gbrobotic/PulseLab/hardware/README.md

Coming in a later phase — see docs/ROADMAP.md.
