gbrobotic/PulseLab/docs/images/phase6_screens.png

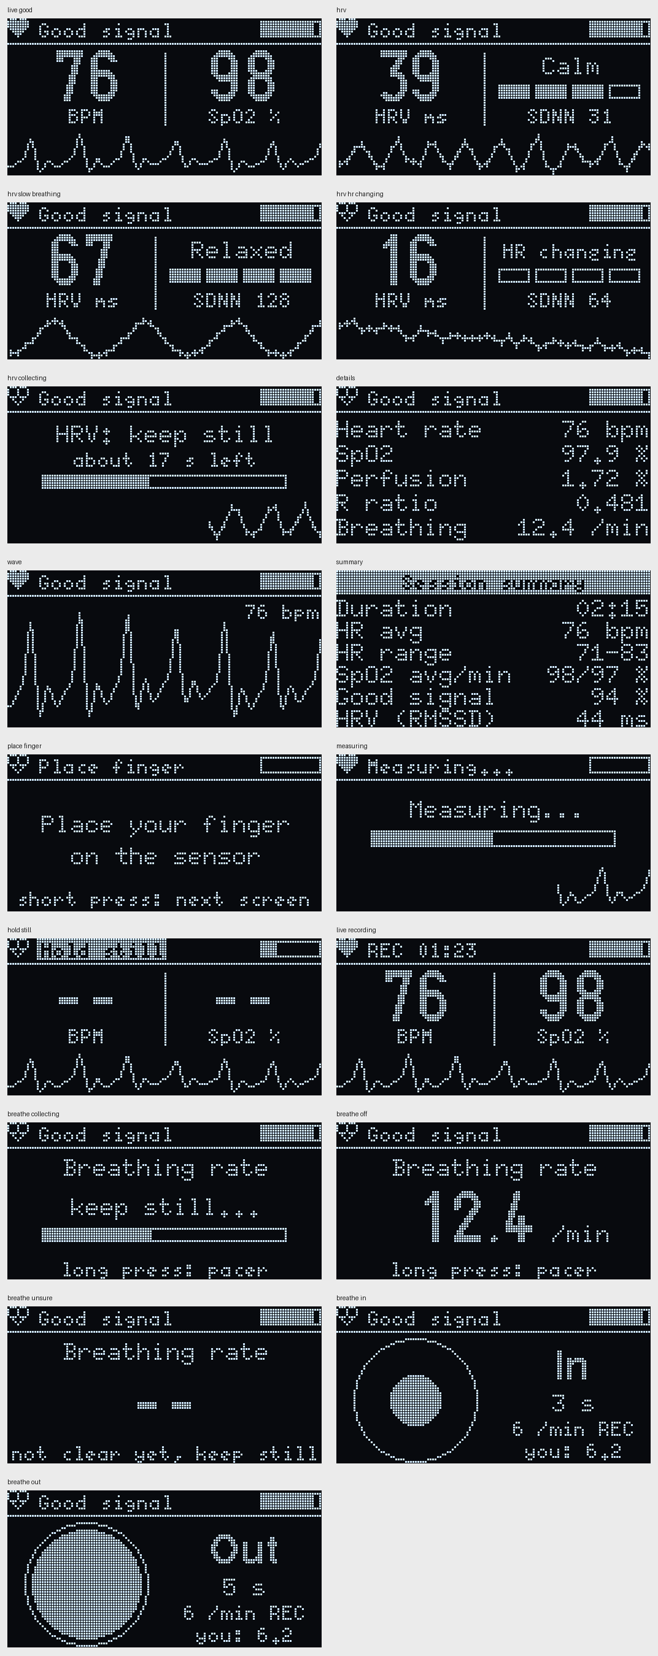
docs/images/phase6_screens.png
