gbrobotic/PulseLab/docs/images/phase6_sim_plot.png

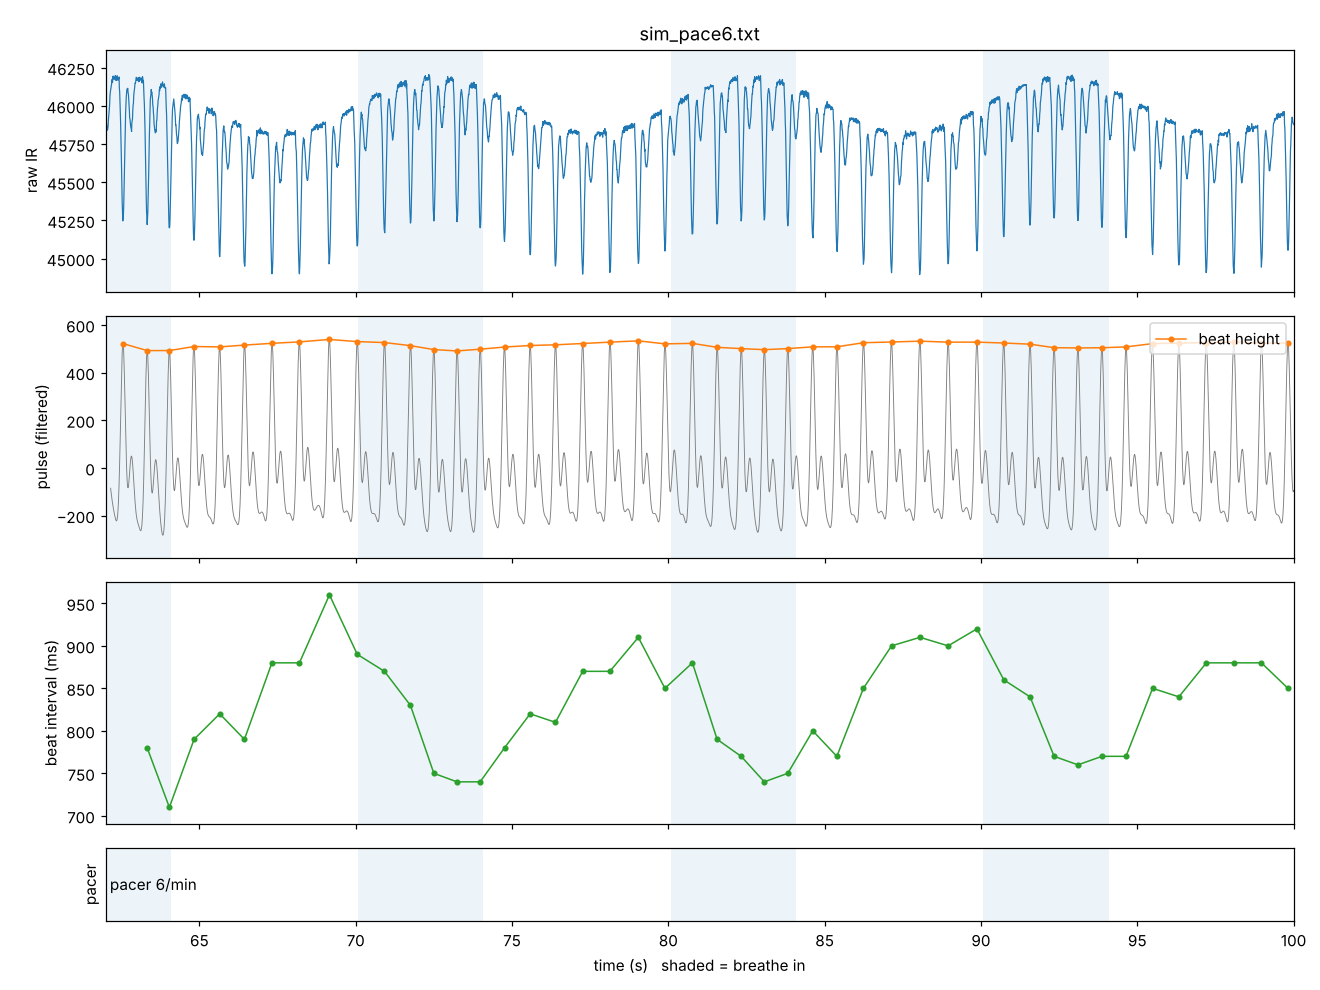
docs/images/phase6_sim_plot.png
