gbrobotic/PulseLab/docs/images/phase7_screens.png

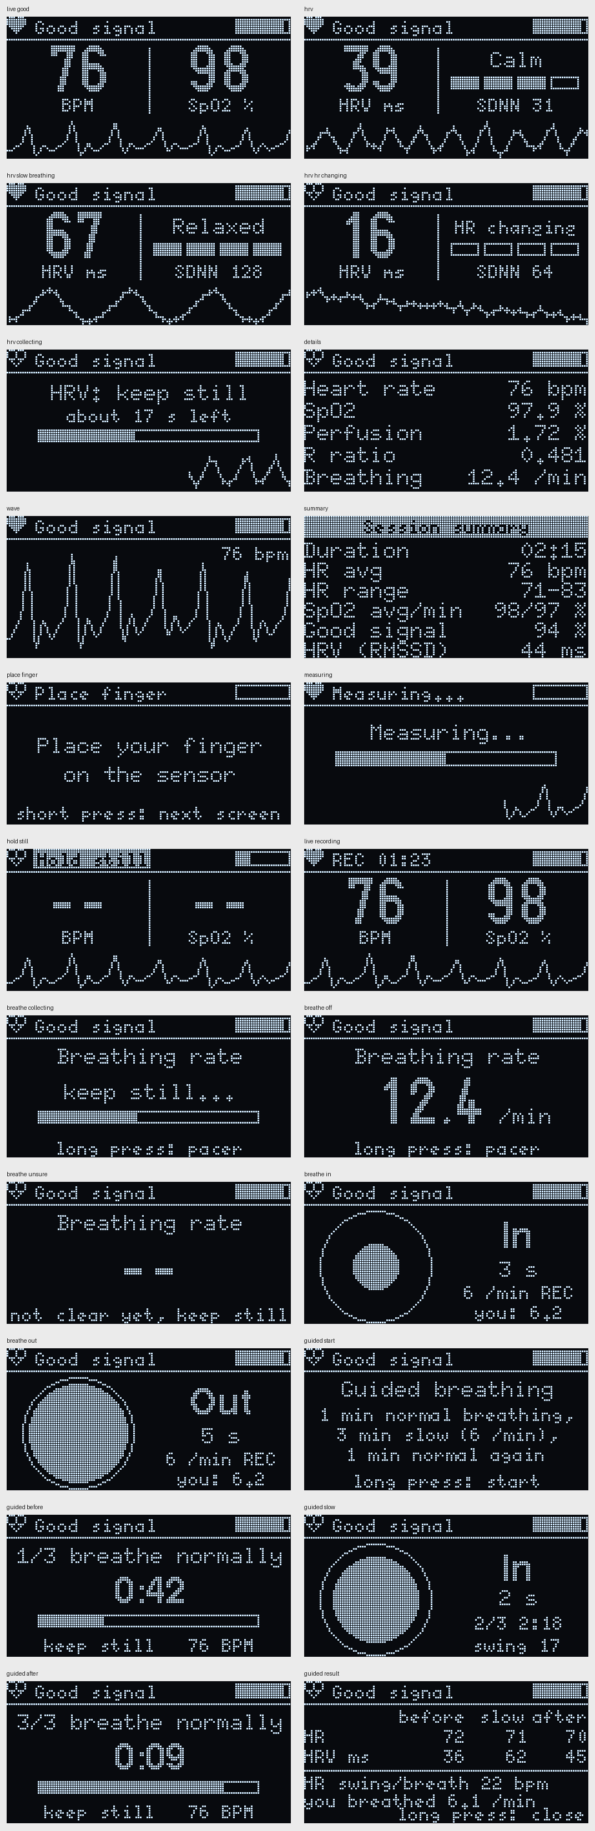
docs/images/phase7_screens.png
