gbrobotic/PulseLab/docs/images/phase10_case_open.png

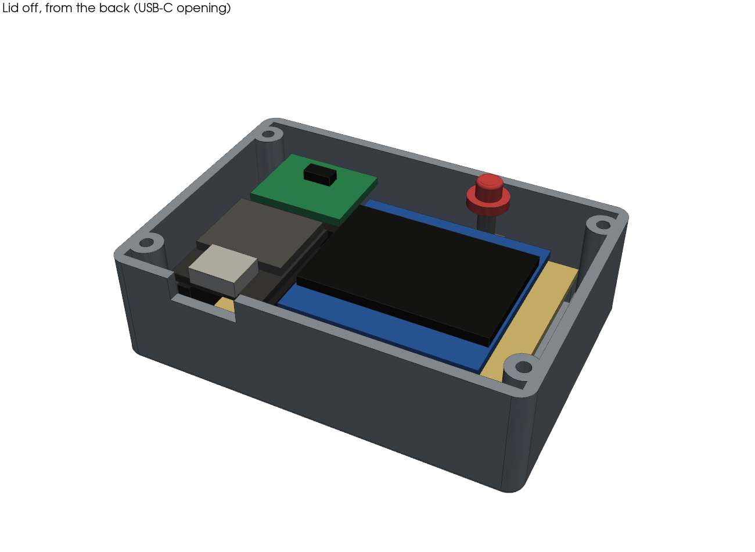
docs/images/phase10_case_open.png
