gbrobotic/PulseLab/enclosure/case_base.step

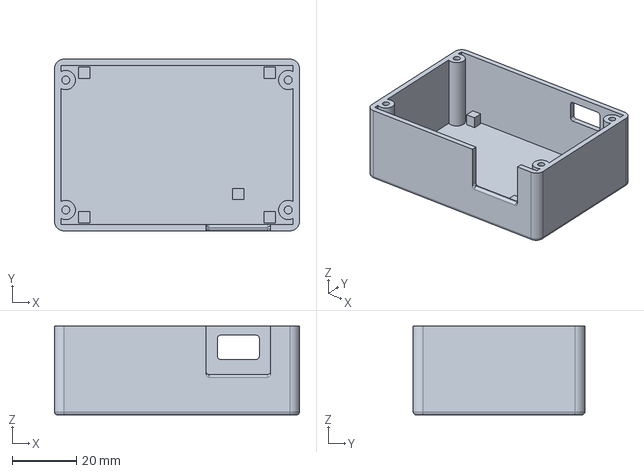
[picture p23: CAD file, 2026-10-22]
enclosure/case_base.step
76.0 x 53.3 x 27.6 mm
