gbrobotic/PulseLab/enclosure/case_lid.step

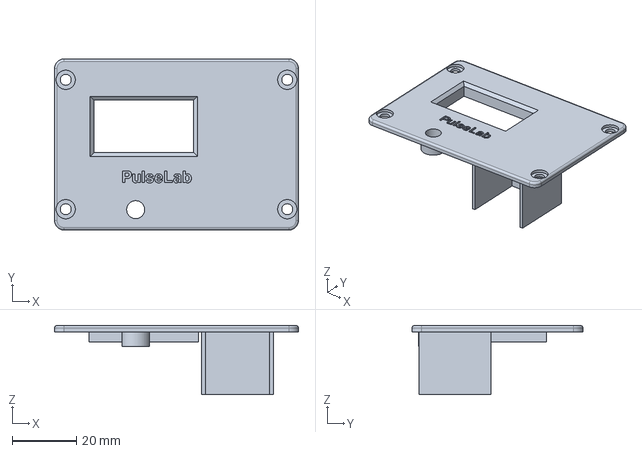
[picture p24: CAD file, 2026-10-22]
enclosure/case_lid.step
76.0 x 53.3 x 21.5 mm
