gbrobotic/PulseLab/enclosure/button_cap.step

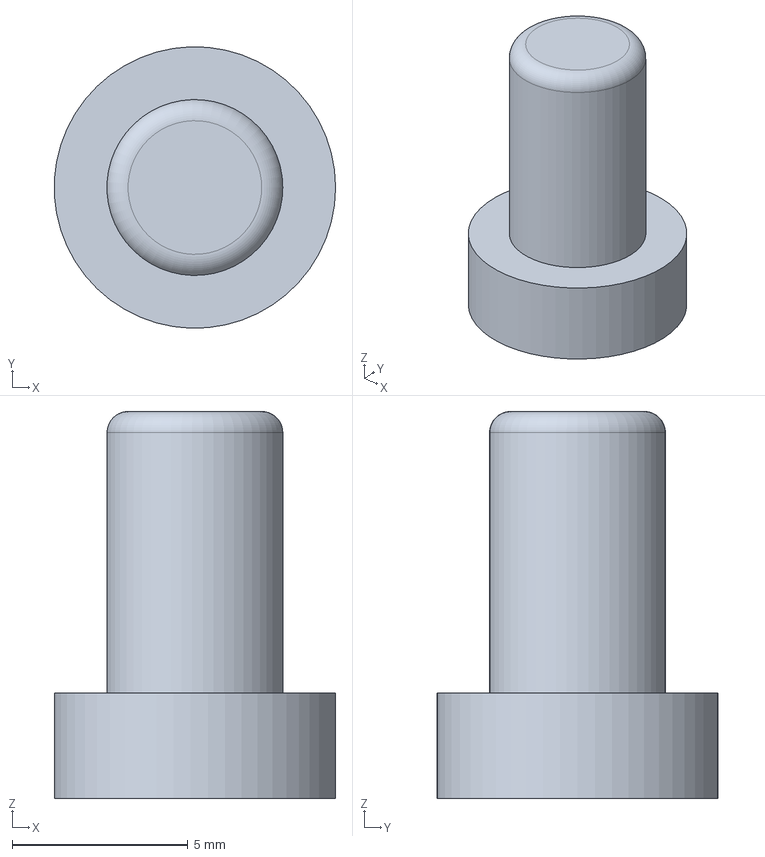
[picture p25: CAD file, 2026-10-22]
enclosure/button_cap.step
7.99 x 8.00 x 11.0 mm
