gbrobotic/PulseLab/enclosure/fit_test_plate.stl

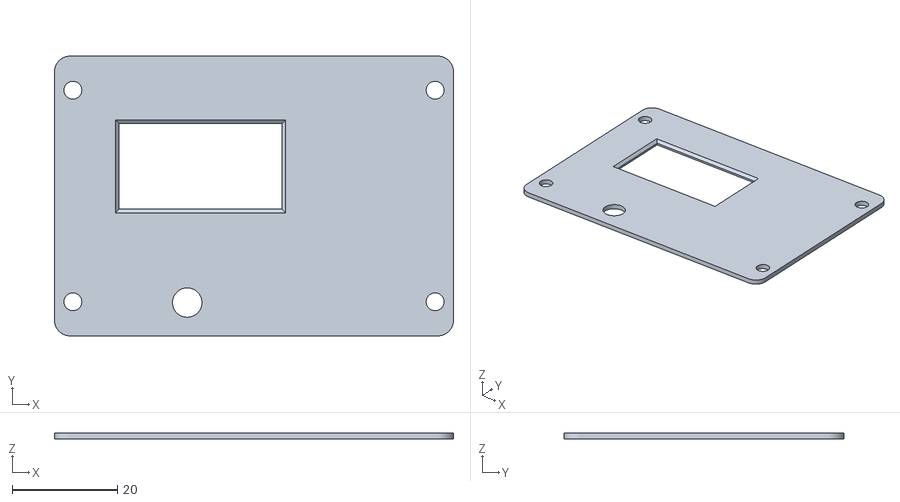
[picture p26: CAD file, 2026-10-22]
enclosure/fit_test_plate.stl
76.0 x 53.3 x 1.20
