gbrobotic/PulseLab/(list of files, cad)

Other CAD files:
enclosure/button_cap.stl
enclosure/case_base.stl
enclosure/case_lid.stl
