gbrobotic/PulseLab/validation/logs/raw_guided1.png

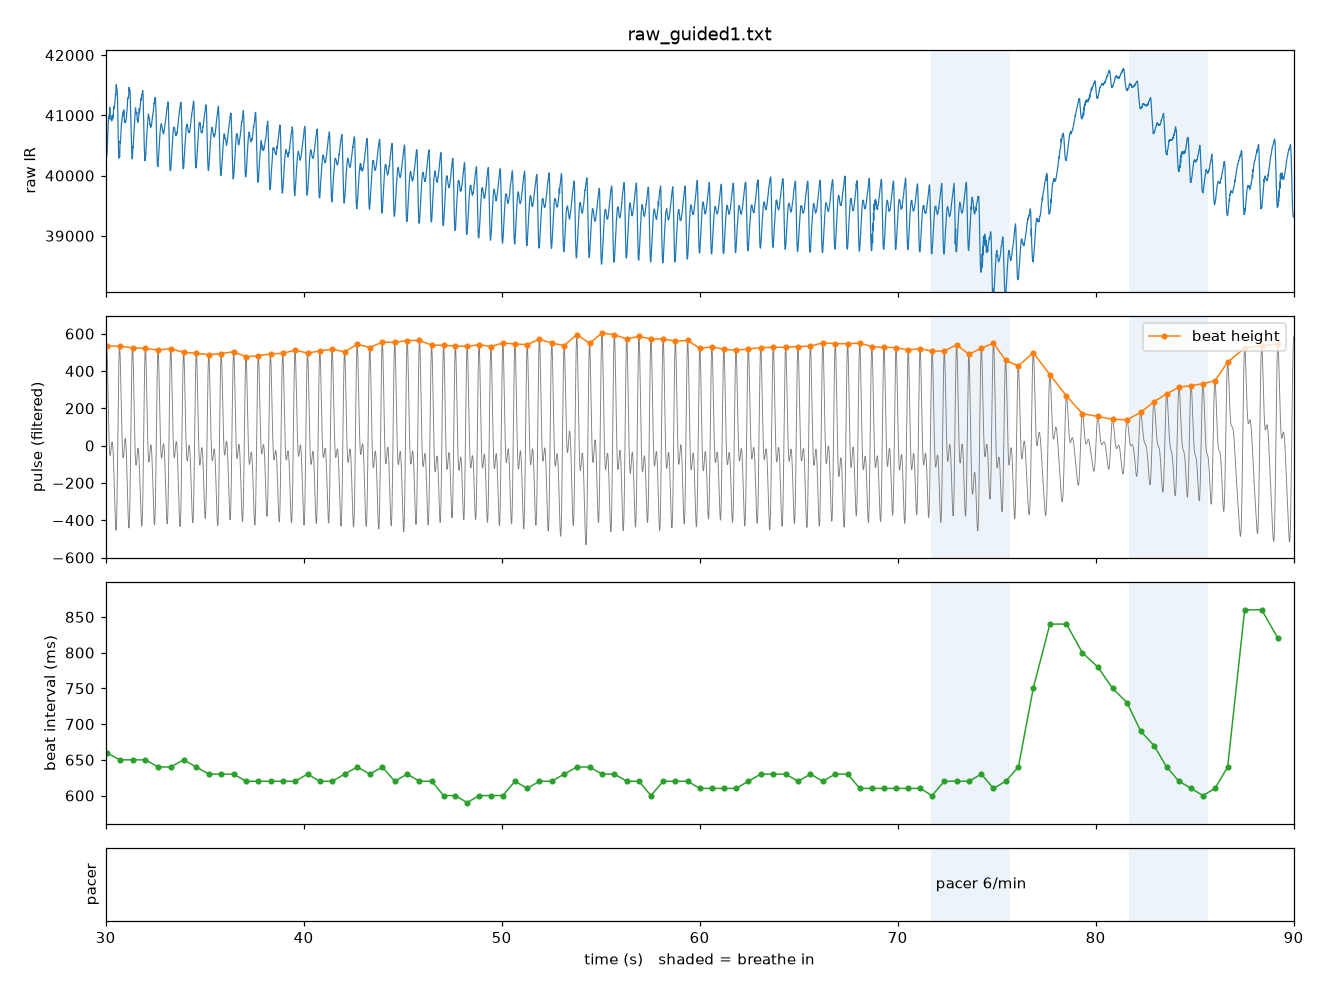
validation/logs/raw_guided1.png
