gbrobotic/PulseLab/validation/logs/dashboard_test1.csv

time | bpm | spo2 | pi | rmssd | breath | quality | stateText | showBpm | showSpo2 | hrvReady | breathValid | guidedPhase
2026-10-20T10:49:07.140Z | 0 | 0 | 0 | 0 | 0 | 0 | Place finger | false | false | false | false | 0
2026-10-20T10:49:07.623Z | 0 | 0 | 0 | 0 | 0 | 0 | Place finger | false | false | false | false | 0
2026-10-20T10:49:08.159Z | 0 | 0 | 0 | 0 | 0 | 0 | Place finger | false | false | false | false | 0
2026-10-20T10:49:08.648Z | 0 | 0 | 0 | 0 | 0 | 0 | Place finger | false | false | false | false | 0
2026-10-20T10:49:09.134Z | 0 | 0 | 0 | 0 | 0 | 0 | Place finger | false | false | false | false | 0
2026-10-20T10:49:09.623Z | 0 | 0 | 0 | 0 | 0 | 0 | Place finger | false | false | false | false | 0
2026-10-20T10:49:10.158Z | 0 | 0 | 0 | 0 | 0 | 0 | Place finger | false | false | false | false | 0
2026-10-20T10:49:10.646Z | 0 | 0 | 0 | 0 | 0 | 0 | Place finger | false | false | false | false | 0
2026-10-20T10:49:11.134Z | 0 | 0 | 0 | 0 | 0 | 0 | Place finger | false | false | false | false | 0
2026-10-20T10:49:11.622Z | 0 | 0 | 0 | 0 | 0 | 0 | Place finger | false | false | false | false | 0
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
