gbrobotic/PulseLab/validation/sim/simulated_readings.csv

# SIMULATED DATA - NOT REAL MEASUREMENTS. Made by make_sim_readings.py to test analyze.py.
reading_id | subject | condition | set | pulselab_hr | reference_hr | pulselab_spo2 | reference_spo2 | pulselab_r | notes
1 | S1 | rest | cal | 68.9 | 71 | 103.0 | 99 | 0.279 | simulated
2 | S1 | rest | cal | 64.0 | 64 | 102.7 | 99 | 0.292 | simulated
3 | S1 | rest | cal | 57.3 | 59 | 100.0 | 98 | 0.400 | simulated
4 | S1 | rest | cal | 68.4 | 69 | 104.4 | 100 | 0.224 | simulated
5 | S1 | after_exercise | cal | 93.2 | 95 | 99.9 | 97 | 0.406 | simulated
6 | S1 | after_exercise | cal | 93.3 | 94 | 103.8 | 99 | 0.249 | simulated
7 | S1 | after_exercise | cal | 85.9 | 89 | 104.1 | 99 | 0.237 | simulated
8 | S2 | rest | cal | 62.3 | 62 | 102.6 | 99 | 0.295 | simulated
9 | S2 | rest | cal | 66.9 | 67 | 99.4 | 97 | 0.423 | simulated
10 | S2 | rest | cal | 67.6 | 67 | 99.3 | 97 | 0.428 | simulated
11 | S2 | rest | cal | 66.0 | 67 | 102.4 | 99 | 0.305 | simulated
12 | S2 | after_exercise | cal | 95.2 | 98 | 99.2 | 96 | 0.432 | simulated
13 | S2 | after_exercise | cal | 89.6 | 90 | 101.1 | 98 | 0.357 | simulated
14 | S2 | after_exercise | cal | 90.1 | 90 | 98.7 | 97 | 0.453 | simulated
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
