gbrobotic/PulseLab/validation/logs/raw_free2.png

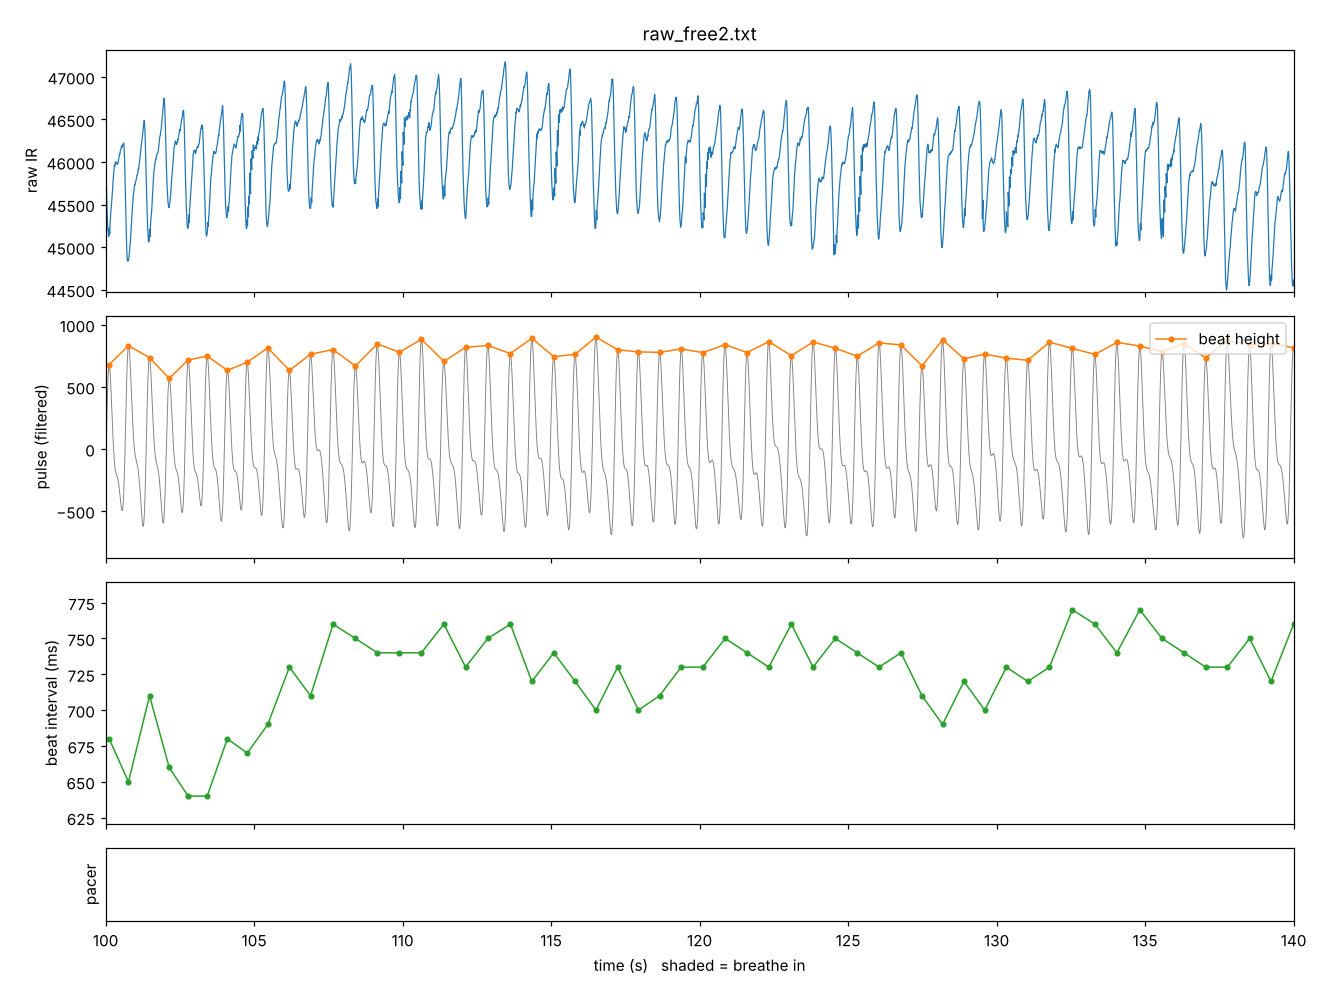
validation/logs/raw_free2.png
