gbrobotic/PulseLab/validation/logs/raw_free.png

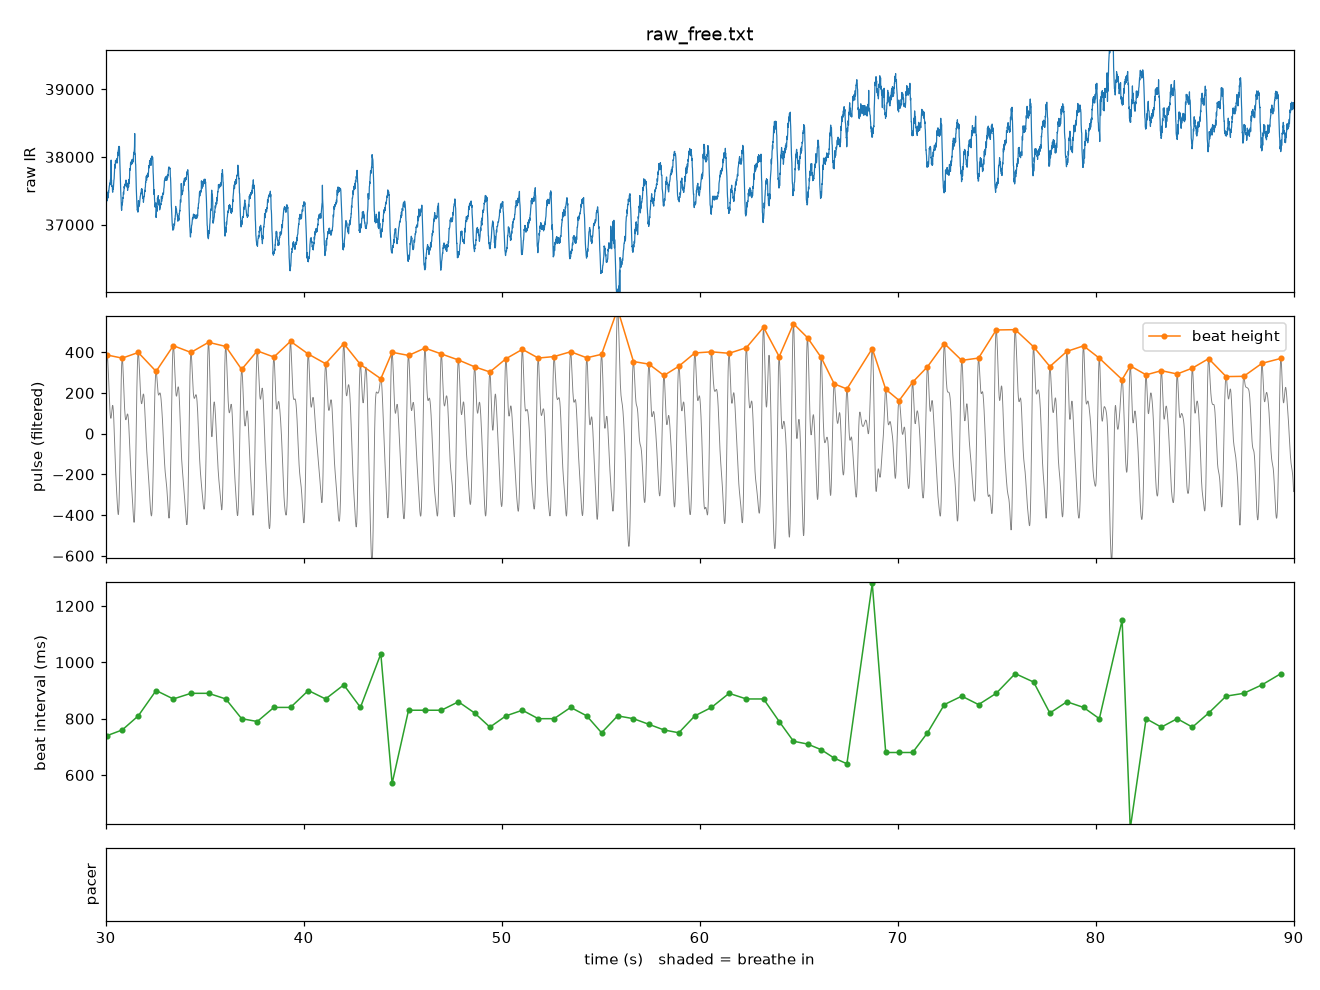
validation/logs/raw_free.png
