gbrobotic/PulseLab/validation/logs/raw_pace6.png

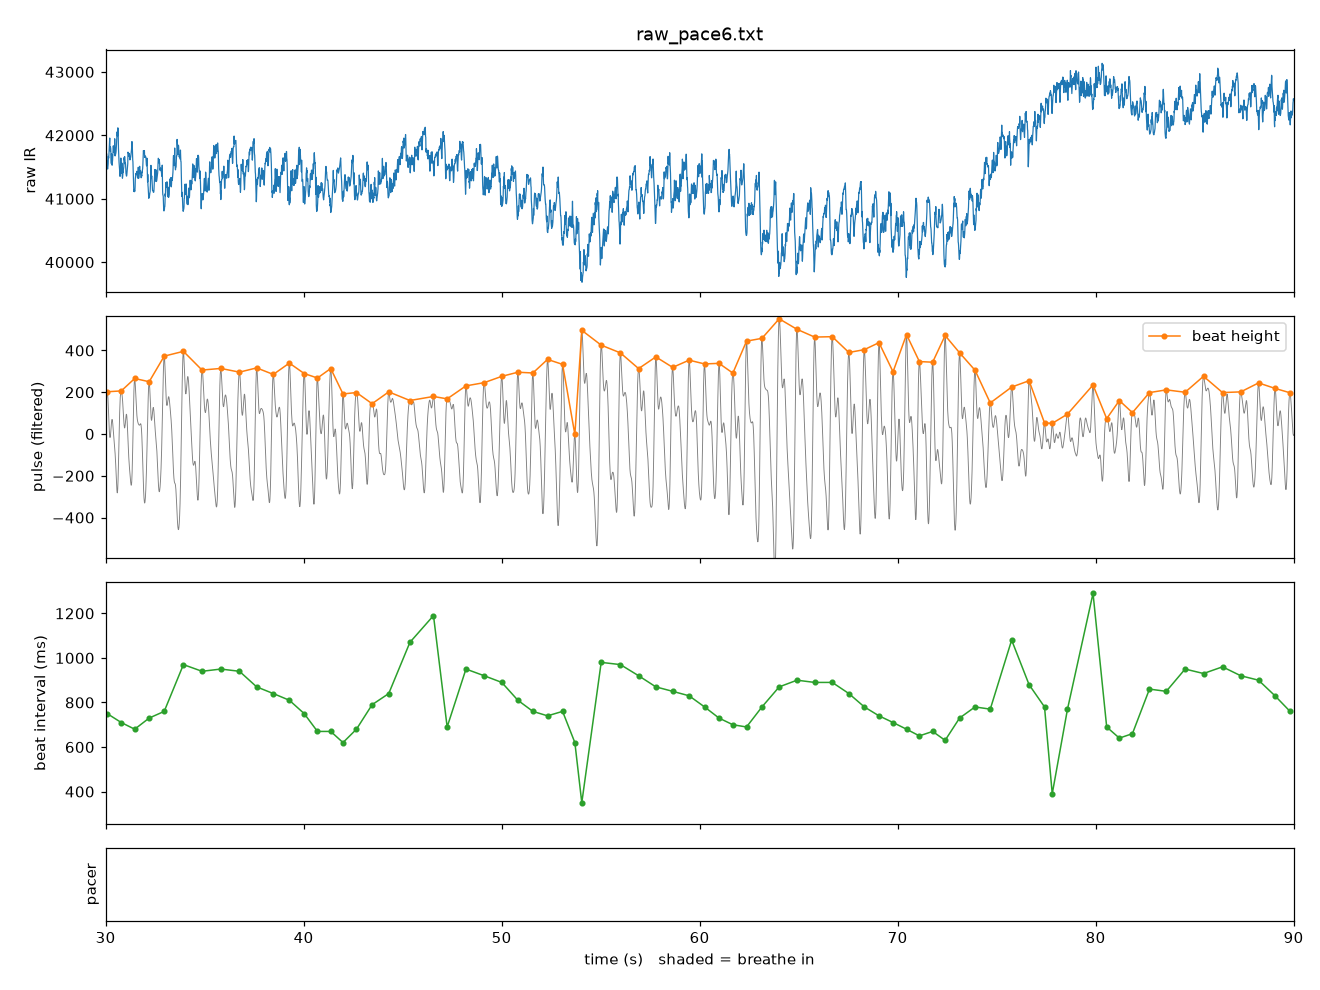
validation/logs/raw_pace6.png
