gbrobotic/PulseLab/validation/logs/raw_pace10.png

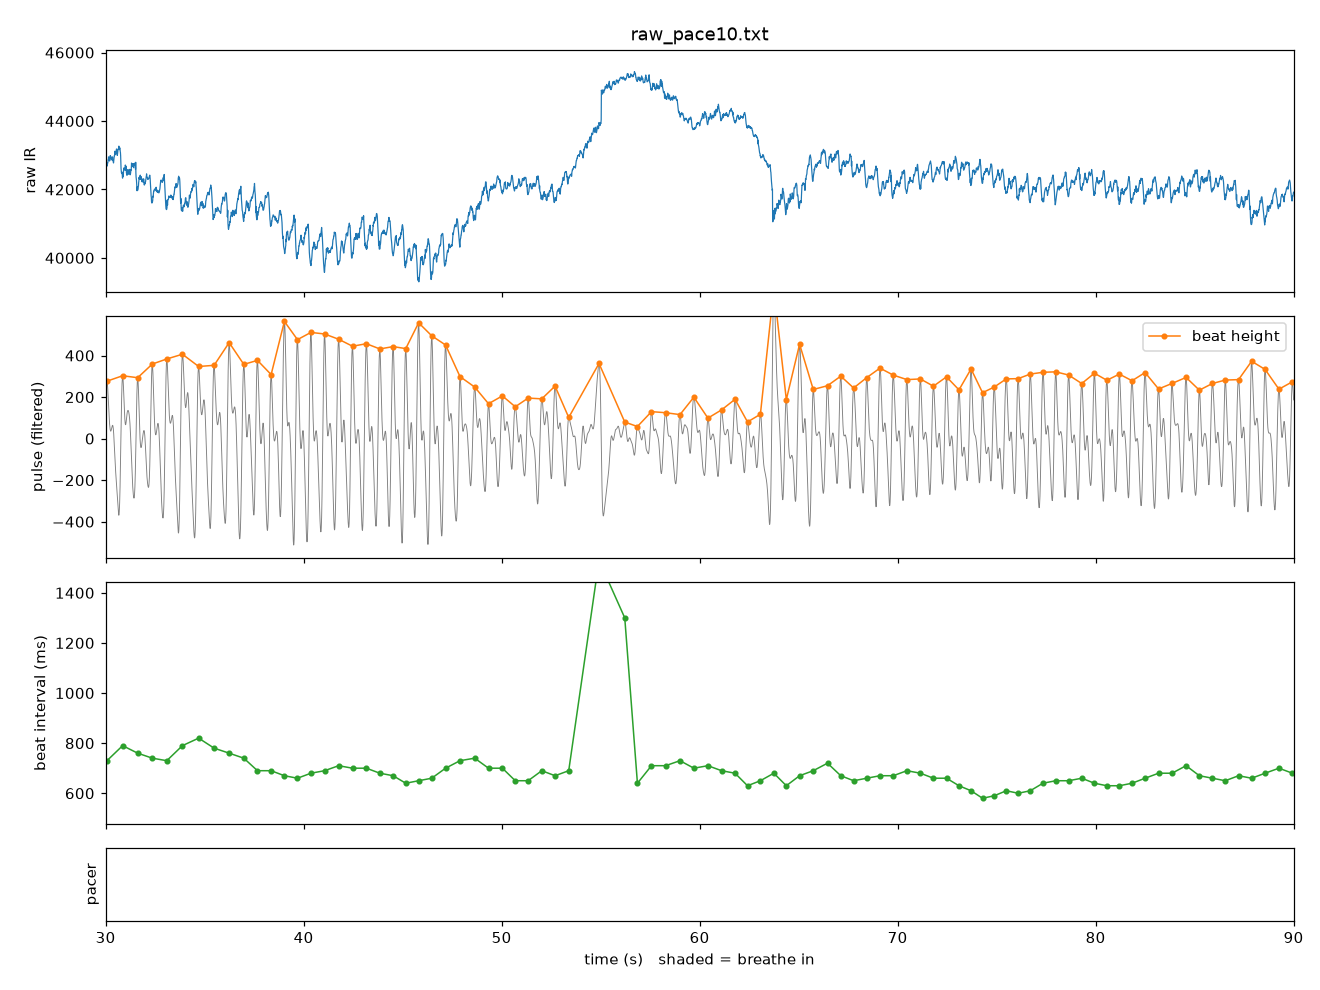
validation/logs/raw_pace10.png
