gbrobotic/PulseLab/validation/logs/raw_pace15.png

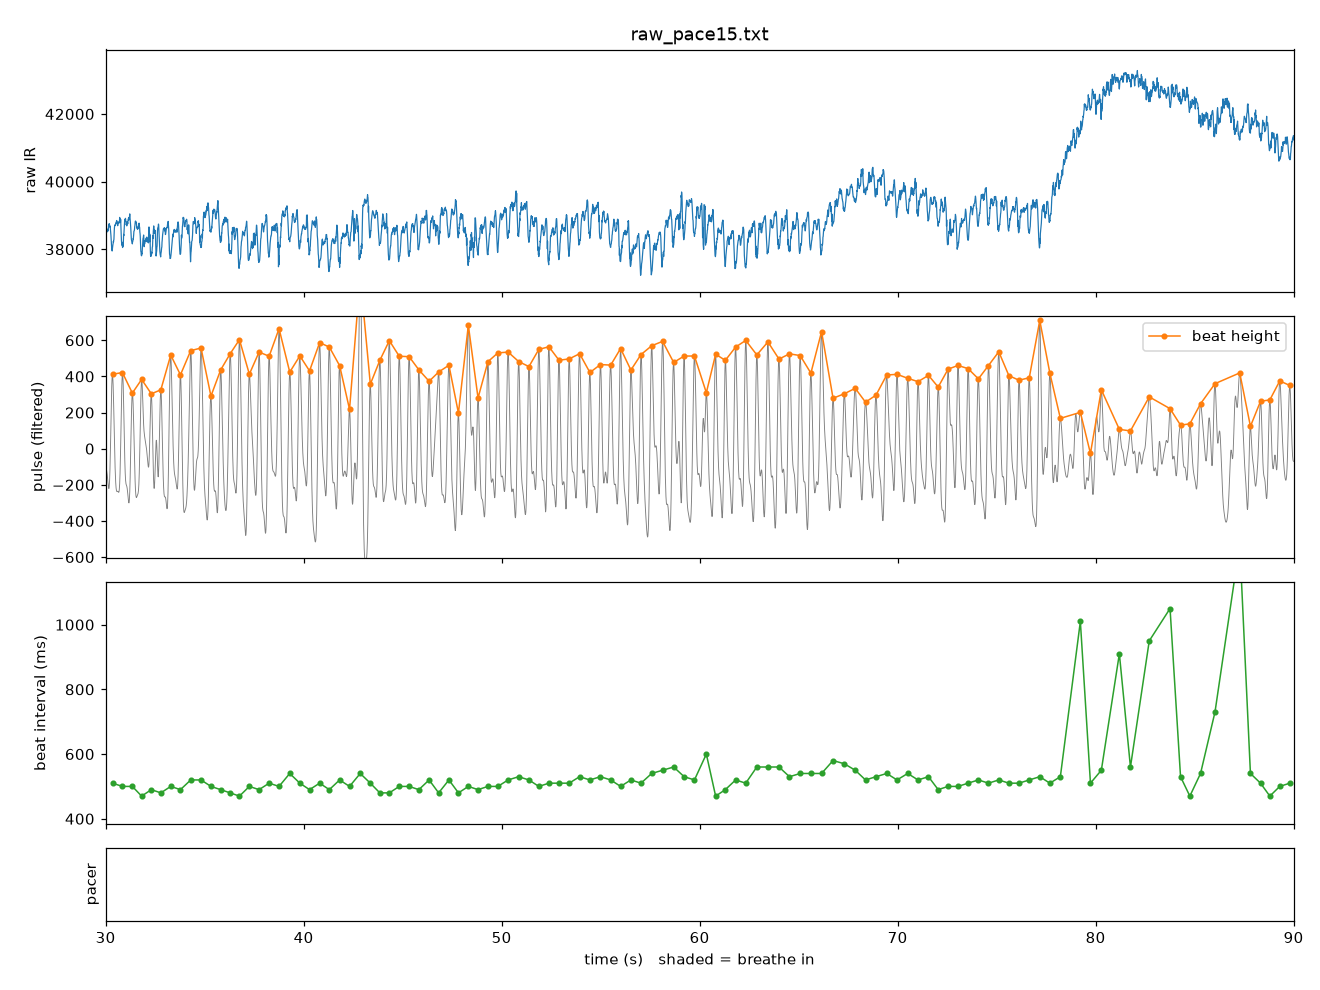
validation/logs/raw_pace15.png
