gbrobotic/PulseLab/validation/logs/raw_pace20.png

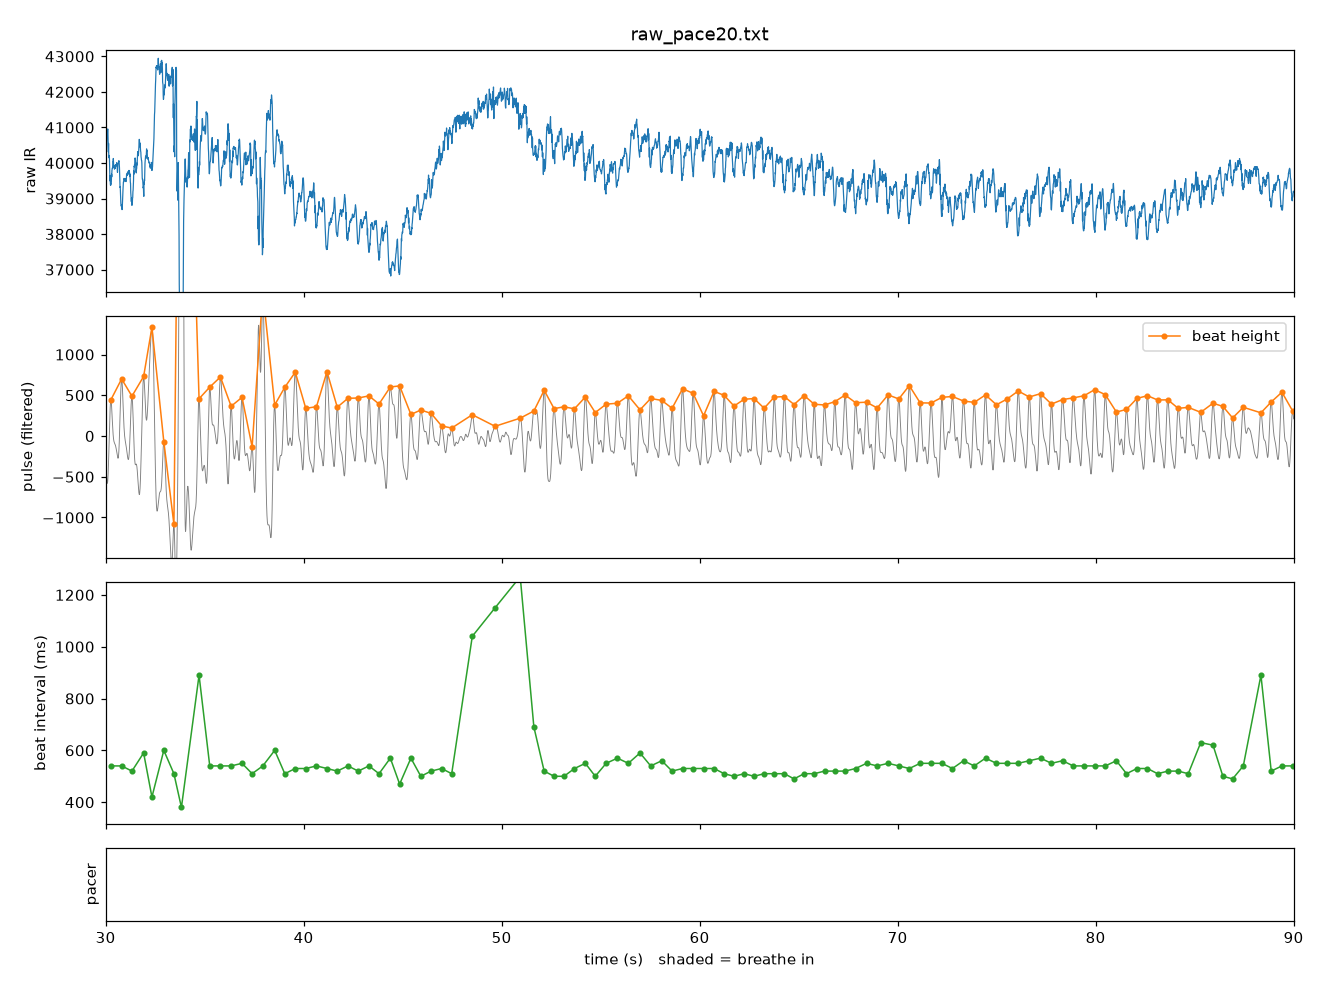
validation/logs/raw_pace20.png
