gbrobotic/PulseLab/validation/sim/bland_altman_hr.png

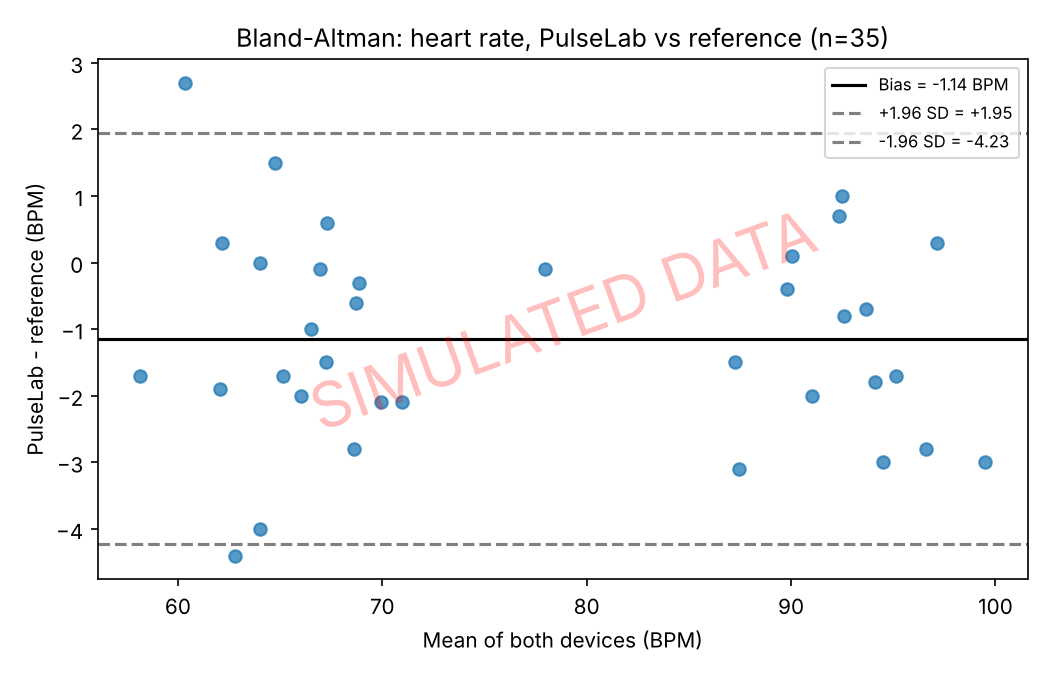
validation/sim/bland_altman_hr.png
