gbrobotic/PulseLab/validation/sim/bland_altman_spo2_cal.png

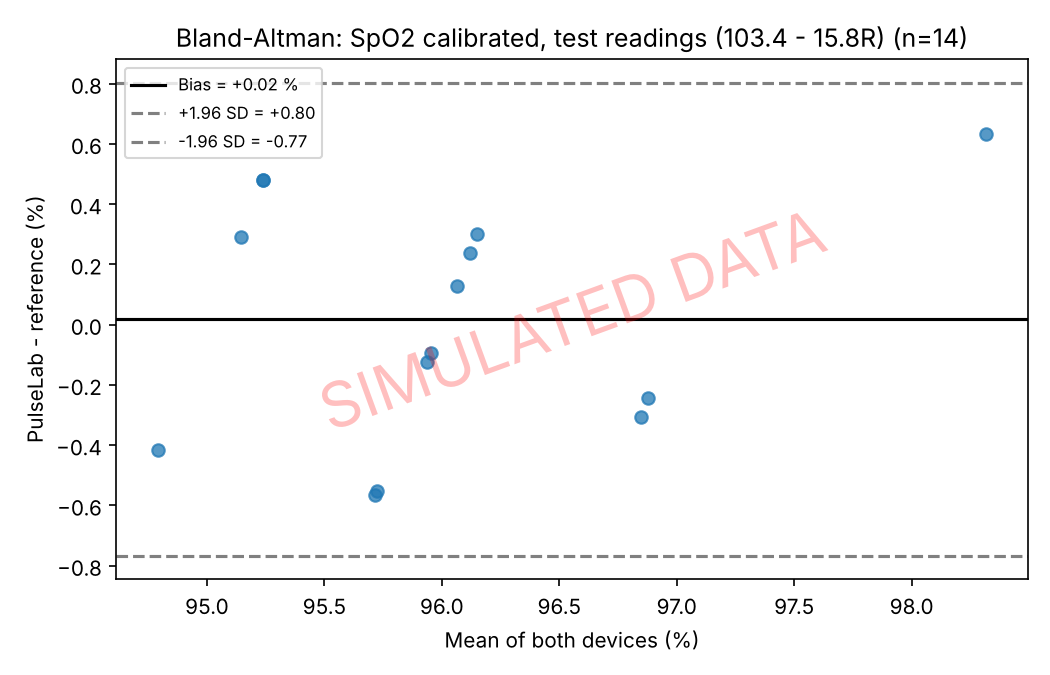
validation/sim/bland_altman_spo2_cal.png
