gbrobotic/PulseLab/validation/sim/bland_altman_spo2_uncal.png

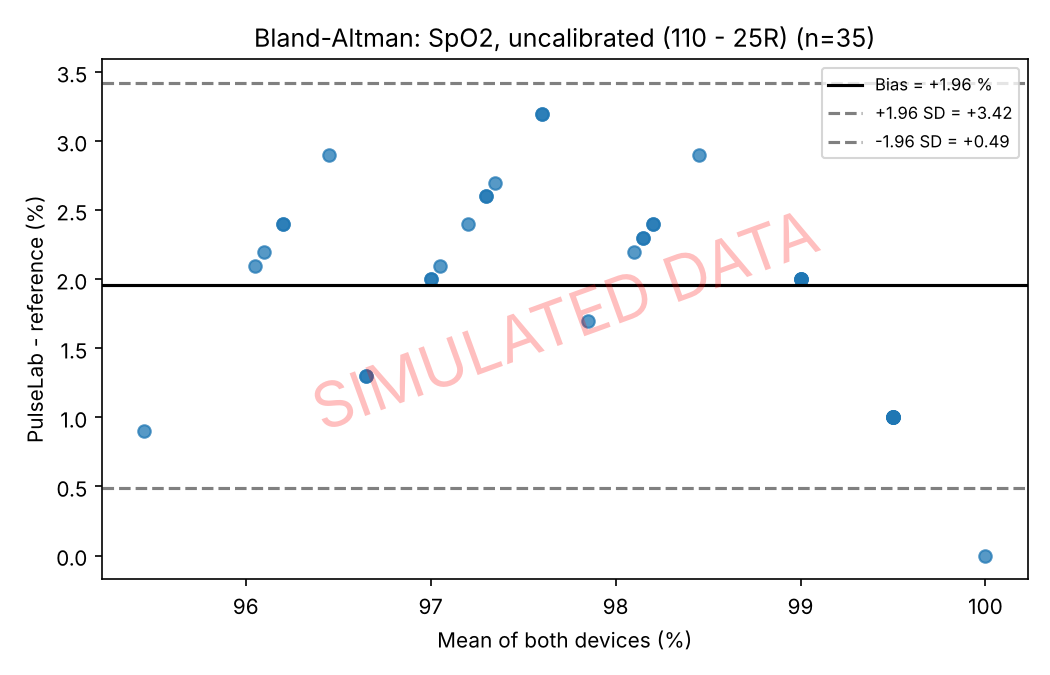
validation/sim/bland_altman_spo2_uncal.png
