gbrobotic/PulseLab/firmware/08_ble/08_ble.ino

/*
 * PulseLab - Phase 8: Bluetooth (BLE) + web dashboard
 *
 * Builds on Phase 7 and adds:
 *   ble_link.h     Bluetooth Low Energy: the standard Heart Rate service (any
 *                  fitness app can show the BPM) and a PulseLab service with
 *                  vitals, pulse wave, guided session and a control channel
 *   ble_packets.h  the byte layout of everything that's sent (tested on the PC)
 *   The web page in dashboard/ connects to it from Chrome (Web Bluetooth).
 *
 * From Phase 7:
 *   guided.h       a 5 minute guided session on the new "Guided" screen:
 *                  1 min normal breathing, 3 min slow breathing with the circle
 *                  (6 per minute), 1 min normal. At the end: heart rate and HRV
 *                  before / during / after, how much the heart rate swung with
 *                  each slow breath, and the breathing rate measured from you
 *
 * From Phase 6:
 *   breathing.h    breathing rate from the pulse: beat timing, pulse height and
 *                  baseline over the last 60 s, shown only when they agree
 *   SERIAL_MODE 3  raw recording: every sensor sample (100 per second) is sent
 *                  over Serial, so the breathing rate code can be developed and
 *                  tested on my real signal on the PC (validation/capture_serial.py)
 *   pacer.h        breathing pacer on a new "Breathe" screen. Breathing along
 *                  with it while recording means the true breathing rate is known
 *
 * Button (GPIO4 to GND):
 *   short press  next screen (Live -> HRV -> Breathe -> Guided -> Details -> Wave)
 *   long press   on the Breathe screen: pacer off / 6 / 10 / 15 / 20 per minute
 *                on the Guided screen: start the guided session / close the result
 *                during a guided session: cancel it (short presses do nothing then)
 *                on other screens: start / stop a recording session
 *
 * Serial (set SERIAL_MODE):
 *   0 = off, 1 = Serial Plotter, 2 = Serial Monitor (one line per beat + status),
 *   3 = raw recording ("index,ir,red" per sample, lines starting with # are notes)
 *
 * Board:     ESP32C3 Dev Module, "USB CDC On Boot" = Enabled
 * Libraries: MAX30100lib (OXullo Intersecans), U8g2 (olikraus)
 * Wiring:    docs/HARDWARE.md. OLED and sensor share SDA=GPIO6, SCL=GPIO7.
 */

#include <Wire.h>
#include <string.h>
#include <U8g2lib.h>
#include "MAX30100_PulseOximeter.h"  // makes the IDE pick OXullo's library
#include "MAX30100.h"
#include "ppg_dsp.h"
#include "spo2.h"
#include "quality.h"
#include "session.h"
#include "breathing.h"
#include "guided.h"
#include "ble_link.h"
#include "ui.h"

using namespace pulselab;

// ---------- Pins ----------
constexpr int PIN_SDA    = 6;
constexpr int PIN_SCL    = 7;
constexpr int PIN_BUTTON = 4;   // to GND, internal pull-up
constexpr int PIN_LED    = 8;   // onboard blue LED, on when LOW
constexpr uint32_t I2C_FREQ_HZ = 400000;

// ---------- Settings ----------
#define SERIAL_MODE 2

// On the ESP32-C3 Super Mini, Serial only goes to USB if "USB CDC On Boot" is
// Enabled. Otherwise it goes to GPIO20/21 and the PC gets nothing at all
// (happened to me twice, DEBUG_LOG #7 and #13), so stop the build instead.
#if SERIAL_MODE != 0 && defined(CONFIG_IDF_TARGET_ESP32C3) && !ARDUINO_USB_CDC_ON_BOOT
#error "Tools > USB CDC On Boot is Disabled, so Serial would not reach the PC. Set it to Enabled (or SERIAL_MODE 0)."
#endif

constexpr uint32_t FRAME_MIN_MS    = 30;   // new frame when a new wave point arrives (every 40 ms = 25 fps)...
constexpr uint32_t FRAME_MAX_MS    = 100;  // ...and at least every 100 ms
constexpr uint32_t FULL_REFRESH_MS = 5000; // send the whole screen now and then, just in case
constexpr uint32_t STALL_MS        = 300;  // no samples for this long = sensor FIFO stuck (see docs)
constexpr uint32_t LONG_PRESS_MS   = 800;
constexpr uint32_t DEBOUNCE_MS     = 30;
constexpr uint32_t BEAT_FLASH_MS   = 150;

U8G2_SH1106_128X64_NONAME_F_HW_I2C oled(U8G2_R0, U8X8_PIN_NONE);
MAX30100 sensor;

HeartRateDetector hr;
Spo2Estimator     spo2;
QualityMonitor    quality;
Session           session;
WaveBuffer        wave;
HrvAnalyzer       hrv;
BreathPacer       pacer;
BeatFeatureTracker beatFeatures;
BreathRateEstimator breath;            // ~7 KB of buffers
GuidedSession     guided;
float             guidedFollow = 0;    // breathing rate measured during the slow part (last valid estimate)
constexpr uint16_t GUIDED_SLOW_SECONDS = 180;  // length of the slow breathing part

BleLink           ble;
constexpr uint32_t BLE_VITALS_MS = 500;   // vitals 2x per second
constexpr uint32_t BLE_GUIDED_MS = 250;   // guided session status 4x per second
float             waveOut[BLE_WAVE_POINTS];   // pulse wave points waiting to be sent
uint8_t           waveOutN = 0, waveSeq = 0;
uint32_t          lastVitalsMs = 0, lastGuidedMs = 0;
uint32_t          loopMaxUs = 0;          // longest loop() since the last status line
uint32_t          sampleIndex = 0;     // counts every sensor sample since start (for the raw recording)

// Latest results, used to draw the screen
HrResult      lastH{};
Spo2Result    lastS{};
QualityResult lastQ{};
HrvResult     lastV{};
Screen        screen = Screen::Live;
uint32_t      fingerSamples = 0;
uint8_t       waveCounter = 0;
bool          newWavePoint = false;
float         shownScore = 0.0f;       // quality bar, smoothed so it slides instead of jumping

// Copy of what's on the OLED, to send only the parts that changed
uint8_t  sentBuffer[1024];
bool     sentValid = false;
uint32_t lastFullRefreshMs = 0;

// Timing / diagnostics
uint32_t lastSampleMs = 0, lastFrameMs = 0, lastStatusMs = 0;
uint32_t beatFlashUntil = 0;
uint32_t frameMs = 0, frameMsMax = 0;
uint32_t framesCount = 0, pagesCount = 0;  // for the status line: frames/s and pages per frame
uint32_t fifoResets = 0;
uint32_t breathMsMax = 0;    // longest breathing-rate step, to check it never gets near the 160 ms FIFO limit
uint16_t lastIr = 0, lastRed = 0;
SignalState lastPrintedState = SignalState::NoFinger;

// ---------- Button: short and long press with debounce ----------
class Button {
public:
  void begin(int pin) { pin_ = pin; pinMode(pin, INPUT_PULLUP); }
  // 0 = nothing, 1 = short press (on release), 2 = long press (while held)
  uint8_t poll(uint32_t now) {
    bool down = digitalRead(pin_) == LOW;
    if (down != raw_) { raw_ = down; changedAt_ = now; }
    if (now - changedAt_ < DEBOUNCE_MS) return 0;
    if (down && !pressed_) { pressed_ = true; pressedAt_ = now; longDone_ = false; }
    else if (!down && pressed_) { pressed_ = false; if (!longDone_) return 1; }
    if (pressed_ && !longDone_ && now - pressedAt_ >= LONG_PRESS_MS) { longDone_ = true; return 2; }
    return 0;
  }
private:
  int pin_ = -1;
  bool raw_ = false, pressed_ = false, longDone_ = false;
  uint32_t changedAt_ = 0, pressedAt_ = 0;
};
Button button;

// ---------- I2C bus recovery (Phase 2, debug log #6) ----------
void i2cBusRecover() {
  pinMode(PIN_SDA, INPUT_PULLUP);
  pinMode(PIN_SCL, OUTPUT_OPEN_DRAIN);
  digitalWrite(PIN_SCL, HIGH);
  delayMicroseconds(5);
  for (int i = 0; i < 9 && digitalRead(PIN_SDA) == LOW; i++) {
    digitalWrite(PIN_SCL, LOW);  delayMicroseconds(5);
    digitalWrite(PIN_SCL, HIGH); delayMicroseconds(5);
  }
  pinMode(PIN_SDA, OUTPUT_OPEN_DRAIN);
  digitalWrite(PIN_SDA, LOW);  delayMicroseconds(5);
  digitalWrite(PIN_SCL, HIGH); delayMicroseconds(5);
  digitalWrite(PIN_SDA, HIGH); delayMicroseconds(5);
}

void showMessage(const char* line1, const char* line2) {
  oled.clearBuffer();
  oled.setFont(u8g2_font_helvB12_tr);
  drawCentered(oled, 64, 22, "PulseLab");
  oled.setFont(u8g2_font_6x10_tf);
  drawCentered(oled, 64, 42, line1);
  drawCentered(oled, 64, 56, line2);
  oled.sendBuffer();
}

void resetMeasurement() {
  hr.reset();
  spo2.reset();
  quality.reset();
  hrv.reset();
  beatFeatures.reset();
  breath.reset();
  wave.clear();
  fingerSamples = 0;
}

void setup() {
  Serial.begin(115200);
#if ARDUINO_USB_CDC_ON_BOOT
  // Never wait for the PC. If USB is plugged in but no Serial Monitor is open,
  // printing could otherwise block long enough to overflow the sensor FIFO.
  Serial.setTxTimeoutMs(0);
#endif

  pinMode(PIN_LED, OUTPUT);
  digitalWrite(PIN_LED, HIGH);
  button.begin(PIN_BUTTON);

  i2cBusRecover();
  Wire.begin(PIN_SDA, PIN_SCL);
  Wire.setClock(I2C_FREQ_HZ);

  oled.setBusClock(I2C_FREQ_HZ);
  oled.begin();
  showMessage("vitals analyzer", "starting...");

  uint8_t attempt = 0;
  while (!sensor.begin()) {
    attempt++;
    if (attempt == 1 || attempt % 5 == 0) {
      Serial.printf("MAX30100 not found (try %u). Check wiring and pull-ups (docs/DEBUG_LOG.md).\n", attempt);
      showMessage("Sensor not found", "check wiring");
    }
    delay(400);
  }
  Wire.setClock(I2C_FREQ_HZ);

  sensor.setMode(MAX30100_MODE_SPO2_HR);
  sensor.setSamplingRate(MAX30100_SAMPRATE_100HZ);
  sensor.setLedsPulseWidth(MAX30100_SPC_PW_1600US_16BITS);
  sensor.setLedsCurrent(MAX30100_LED_CURR_50MA, MAX30100_LED_CURR_27_1MA);
  sensor.setHighresModeEnabled(true);
  sensor.resetFifo();

  resetMeasurement();

  // Bluetooth: shows up as "PulseLab" in Chrome and in BLE apps
  ble.begin("PulseLab");
  lastSampleMs = millis();
  sensor.resetFifo();   // BLE start-up takes a moment, start with an empty FIFO

#if SERIAL_MODE == 2
  Serial.println(F("PulseLab Phase 8 starting, Bluetooth name: PulseLab"));
#elif SERIAL_MODE == 3
  Serial.println(F("# PulseLab Phase 8 raw recording: index,ir,red at 100 Hz"));
#endif
}

// ---------- Per sample ----------
void processSample(uint16_t ir, uint16_t red) {
  lastIr = ir; lastRed = red;
  sampleIndex++;
  pacer.tick();
#if SERIAL_MODE == 3
  // One short line per sample, ~2 KB/s. The index lets the PC check that
  // nothing was lost (Serial never waits, so if the PC falls behind, lines drop).
  Serial.printf("%lu,%u,%u\n", (unsigned long)sampleIndex, ir, red);
#endif
  HrResult h = hr.process((float)ir);
  Spo2Result s = spo2.process((float)ir, (float)red, h);
  QualityResult q = quality.process(h, s, (float)ir, (float)red);
  HrvResult v = hrv.process(h, q);
  session.process(h, s, q);
  BeatFeature bf;
  if (beatFeatures.process((float)ir, h, q, bf)) breath.addBeat(bf);
  if (!h.finger) breath.reset();
  guided.process(h, q);
  if (guided.result().changed) guidedPhaseChanged();

  fingerSamples = h.finger ? fingerSamples + 1 : 0;
  if (++waveCounter >= 4) {  // one wave point per 40 ms
    waveCounter = 0;
    bool show = h.finger && !h.settling;
    bool good = show && q.state != SignalState::Moving && q.state != SignalState::Clipping;
    wave.push(show ? h.signal : 0.0f, good);
    newWavePoint = true;
    // the same point goes to the web page, 8 at a time
    waveOut[waveOutN++] = show ? h.signal : 0.0f;
    if (waveOutN == BLE_WAVE_POINTS) {
      uint8_t p[BLE_WAVE_LEN];
      packWave(p, waveSeq++, waveOut);
      ble.sendWave(p);
      waveOutN = 0;
    }
  }

  if (h.beat) {
    beatFlashUntil = millis() + BEAT_FLASH_MS;
    digitalWrite(PIN_LED, LOW);
    // standard Heart Rate service: BPM + this beat's interval, only when the BPM is shown on the OLED too
    if (q.showBpm && h.bpm > 0) ble.sendHeartRate(h.bpm, h.finger, h.ibiValid ? h.ibiMs : 0);
  }

#if SERIAL_MODE == 1
  static uint8_t plotCounter = 0;
  if (++plotCounter >= 4) {
    plotCounter = 0;
    Serial.printf("IR:%.1f,BPM:%.1f,SpO2:%.1f,Quality:%u\n",
                  (h.finger && !h.settling) ? h.signal : 0.0f,
                  q.showBpm ? h.bpm : 0.0f, q.showSpo2 ? s.spo2 : 0.0f, q.score);
  }
#elif SERIAL_MODE == 2
  if (q.state != lastPrintedState) {
    Serial.printf("[%s]\n", stateText(q.state));
    lastPrintedState = q.state;
  }
  if (h.beat && h.ibiMs > 0) {
    char hrvText[32];
    if (v.ready) snprintf(hrvText, sizeof hrvText, "HRV %.1f %s", v.rmssd, v.steady ? stressText(v.level) : "(HR changing)");
    else snprintf(hrvText, sizeof hrvText, "HRV -- (%d%%)", (int)(v.progress * 100));
    const BreathResult& br = breath.result();
    char respText[20];
    if (br.valid) snprintf(respText, sizeof respText, "Resp %.1f", br.rate);
    else snprintf(respText, sizeof respText, "Resp -- (%d%%)", (int)(br.progress * 100));
    Serial.printf("Beat %4u ms %-3s BPM %5.1f | SpO2 %5.1f%% PI %.2f%% R %.3f | %s | %s | quality %3u | h %.0f%s%s\n",
                  h.ibiMs, h.ibiValid ? "ok" : "rej", h.bpm, s.spo2, s.pi, s.r, hrvText, respText, q.score, h.beatHeight,
                  q.showBpm ? "" : "  (BPM hidden)", q.showSpo2 ? "" : "  (SpO2 hidden)");
  }
  if (h.secondBump) Serial.printf("  (skipped 2nd bump, h %.0f)\n", h.beatHeight);  // h = slope peak height
#endif

  lastH = h; lastS = s; lastQ = q; lastV = v;
}

void printGuidedResult() {
#if SERIAL_MODE == 2 || SERIAL_MODE == 3
  const GuidedResult& g = guided.result();
  // seconds of slow breathing, HR before/slow/after, RMSSD before/slow/after, swing, swing breaths, breathing rate,
  // SDNN before/slow/after (added in Phase 8, at the end so older parsers still work)
  Serial.printf("%sGUIDED_CSV,%u,%.1f,%.1f,%.1f,%.1f,%.1f,%.1f,%.1f,%u,%.1f,%.1f,%.1f,%.1f\n", SERIAL_MODE == 3 ? "# " : "",
                GUIDED_SLOW_SECONDS, g.before.bpm, g.during.bpm, g.after.bpm, g.before.rmssd, g.during.rmssd, g.after.rmssd,
                g.swing, g.swingBreaths, guidedFollow, g.before.sdnn, g.during.sdnn, g.after.sdnn);
#endif
}

// Called when the guided session moves to the next part.
void guidedPhaseChanged() {
  const GuidedResult& g = guided.result();
  if (g.phase == GuidedPhase::Breathe) guidedFollow = 0;
#if SERIAL_MODE == 2
  Serial.printf("[Guided: %s]\n", guidedPhaseText(g.phase));
#elif SERIAL_MODE == 3
  Serial.printf("# guided %s from %lu\n", guidedPhaseText(g.phase), (unsigned long)sampleIndex);
  // pace notes too, so replay_raw knows the true breathing rate in the slow part
  if (g.phase == GuidedPhase::Breathe) Serial.printf("# pace %u from %lu\n", GUIDED_PACE, (unsigned long)sampleIndex);
  if (g.phase == GuidedPhase::After) Serial.printf("# pace 0 from %lu\n", (unsigned long)sampleIndex);
#endif
  if (g.phase == GuidedPhase::Done) {
    printGuidedResult();
    uint8_t p[RESULT_LEN];
    packResult(p, g, guidedFollow);
    ble.sendResult(p);
  }
}

void printSessionSummary(const SessionSummary& s) {
#if SERIAL_MODE == 2
  Serial.printf("\nSession: %lu s, HR avg %.1f (%.1f-%.1f, %u beats), SpO2 avg %.1f min %.1f (%u beats), good signal %u%%, HRV %.1f ms\n",
                (unsigned long)s.seconds, s.bpmAvg, s.bpmMin, s.bpmMax, s.bpmCount,
                s.spo2Avg, s.spo2Min, s.spo2Count, s.goodPct, s.rmssd);
  // One line that can be pasted straight into a spreadsheet (Phase 11):
  // seconds, HR avg, HR min, HR max, SpO2 avg, SpO2 min, good %, RMSSD
  Serial.printf("SESSION_CSV,%lu,%.1f,%.1f,%.1f,%.1f,%.1f,%u,%.1f\n\n",
                (unsigned long)s.seconds, s.bpmAvg, s.bpmMin, s.bpmMax, s.spo2Avg, s.spo2Min, s.goodPct, s.rmssd);
#else
  (void)s;
#endif
}

void handleButton(uint32_t now) {
  uint8_t ev = button.poll(now);
  if (guided.active()) {           // during a guided session: only cancel
    screen = Screen::Guided;
    if (ev == 2) {
      guided.stop();
#if SERIAL_MODE == 2
      Serial.println(F("[Guided: cancelled]"));
#elif SERIAL_MODE == 3
      Serial.printf("# guided cancelled at %lu\n# pace 0 from %lu\n", (unsigned long)sampleIndex, (unsigned long)sampleIndex);
#endif
    }
    return;
  }
  if (ev == 2 && screen == Screen::Guided) {   // start, or close the result
    if (guided.result().phase == GuidedPhase::Done) guided.stop();
    else if (lastH.finger) { guidedFollow = 0; guided.start(GUIDED_SLOW_SECONDS); guidedPhaseChanged(); }
    return;
  }
  if (ev == 1) {  // short press: next screen
    switch (screen) {
      case Screen::Live:    screen = Screen::Hrv; break;
      case Screen::Hrv:     screen = Screen::Breathe; break;
      case Screen::Breathe: screen = Screen::Guided; break;
      case Screen::Guided:  screen = Screen::Details; break;
      case Screen::Details: screen = Screen::Wave; break;
      case Screen::Wave:    screen = Screen::Live; break;
      case Screen::Summary: screen = Screen::Live; break;
    }
  } else if (ev == 2 && screen == Screen::Breathe) {  // long press on Breathe: change the pace
    uint8_t pace = pacer.next();
#if SERIAL_MODE == 3
    // note in the recording, so the PC knows the true breathing rate from here on
    Serial.printf("# pace %u from %lu\n", pace, (unsigned long)sampleIndex);
#else
    (void)pace;
#endif
  } else if (ev == 2) {  // long press: start / stop session
    if (session.active()) {
      session.stop(lastV.ready ? lastV.rmssd : 0.0f);
      printSessionSummary(session.summary());
      screen = Screen::Summary;
    } else {
      session.start();
      screen = Screen::Live;
#if SERIAL_MODE == 2
      Serial.println(F("\nSession started"));
#endif
    }
  }
}

// The SH1106 is split into 8 "pages" (strips of 8 rows, 128 bytes each).
// Sending all 8 takes ~33 ms. Most frames only change a few pages (mainly
// the wave), so only those are sent. That's what makes 25 fps possible.
uint8_t sendChangedPages(uint32_t now) {
  uint8_t* buf = oled.getBufferPtr();
  bool full = !sentValid || (now - lastFullRefreshMs >= FULL_REFRESH_MS);
  uint8_t sent = 0;
  for (uint8_t page = 0; page < 8; page++) {
    uint8_t* cur = buf + page * 128;
    uint8_t* old = sentBuffer + page * 128;
    if (full || memcmp(cur, old, 128) != 0) {
      oled.updateDisplayArea(0, page, 16, 1);   // 16 tiles of 8 px = whole width, 1 page high
      memcpy(old, cur, 128);
      sent++;
    }
  }
  if (full) { sentValid = true; lastFullRefreshMs = now; }
  return sent;
}

void drawFrame(uint32_t now) {
  shownScore += 0.25f * ((float)lastQ.score - shownScore);

  UiData u{};
  u.screen = screen;
  u.q = lastQ;
  u.q.score = (uint8_t)(shownScore + 0.5f);
  u.bpm = lastH.bpm;
  u.spo2 = lastS.spo2;
  u.pi = lastS.pi;
  u.r = lastS.r;
  u.beatFlash = now < beatFlashUntil;
  u.fingerSec = fingerSamples / 100.0f;
  u.wave = &wave;
  u.sessionActive = session.active();
  u.sessionSec = session.seconds();
  u.summary = &session.summary();
  u.hrv = &lastV;
  u.hrvHistory = &hrv;
  u.pacer = pacer.state();
  u.recording = (SERIAL_MODE == 3);
  u.breath = &breath.result();
  u.guided = &guided.result();
  u.guidedPacer = guided.pacerState();
  u.guidedFollow = guidedFollow;

  uint32_t t0 = millis();
  wave.updateScale();
  drawScreen(oled, u);
  pagesCount += sendChangedPages(now);
  framesCount++;
  frameMs = millis() - t0;
  if (frameMs > frameMsMax) frameMsMax = frameMs;
}

// Commands written by the web page (control characteristic)
void handleBleCommand() {
  uint8_t cmd = ble.takeCommand();
  if (cmd == CMD_START_GUIDED && !guided.active() && lastH.finger) {
    if (guided.result().phase == GuidedPhase::Done) guided.stop();
    guidedFollow = 0;
    guided.start(GUIDED_SLOW_SECONDS);
    screen = Screen::Guided;
    guidedPhaseChanged();
  } else if (cmd == CMD_CANCEL_GUIDED) {
    guided.stop();
  }
}

// Vitals 2x per second, guided status 4x per second during a session.
void sendBle(uint32_t now) {
  ble.loop(now);
  if (!ble.connected()) return;
  if (now - lastVitalsMs >= BLE_VITALS_MS) {
    lastVitalsMs = now;
    uint8_t p[VITALS_LEN];
    packVitals(p, lastH, lastS, lastQ, lastV, breath.result(), guided.result());
    ble.sendVitals(p);
  }
  if (guided.active() && now - lastGuidedMs >= BLE_GUIDED_MS) {
    lastGuidedMs = now;
    uint8_t p[GUIDED_LEN];
    packGuided(p, guided.result(), guided.pacerState());
    ble.sendGuided(p);
  }
}

void loop() {
  uint32_t now = millis();
  uint32_t loopStartUs = micros();

  // 1. Read everything the sensor has collected
  sensor.update();
  uint16_t ir, red;
  bool got = false;
  while (sensor.getRawValues(&ir, &red)) {
    processSample(ir, red);
    got = true;
  }
  if (got) lastSampleMs = now;

  // 2. Watchdog: the library can't read a completely full FIFO (16 samples),
  //    so if the loop was ever blocked for >160 ms the data would stop for good.
  //    If no samples arrive for 300 ms, reset the FIFO and start measuring again.
  if (now - lastSampleMs > STALL_MS) {
    sensor.resetFifo();
    resetMeasurement();
    fifoResets++;
    lastSampleMs = now;
#if SERIAL_MODE == 2
    Serial.println(F("Sensor FIFO stalled, reset"));
#elif SERIAL_MODE == 3
    Serial.printf("# fifo reset at %lu (samples were lost here)\n", (unsigned long)sampleIndex);
#endif
  }

  // 3. Breathing rate: every 5 s an estimate is due. It's split into a few
  //    steps of ~15 ms (one per loop) so the sensor FIFO never fills up.
  uint32_t t0 = millis();
  if (breath.update()) {
    // remember the last good breathing rate during the slow part, for the result screen
    if (guided.result().phase == GuidedPhase::Breathe && breath.result().valid) guidedFollow = breath.result().rate;
#if SERIAL_MODE == 3
    const BreathResult& b = breath.result();
    // note in the raw recording, to compare the device with the PC replay
    Serial.printf("# breathing %.1f valid %u agree %u at %lu\n", b.valid ? b.rate : 0.0f, b.valid, b.agree, (unsigned long)sampleIndex);
#endif
  }
  uint32_t breathMs = millis() - t0;
  if (breathMs > breathMsMax) breathMsMax = breathMs;

  // 4. Button and Bluetooth
  handleButton(now);
  handleBleCommand();
  sendBle(now);

  // 5. Screen: one frame per new wave point, so the wave scrolls 1 pixel at a time
  uint32_t sinceFrame = now - lastFrameMs;
  if ((newWavePoint && sinceFrame >= FRAME_MIN_MS) || sinceFrame >= FRAME_MAX_MS) {
    lastFrameMs = now;
    newWavePoint = false;
    drawFrame(now);
  }

  // 6. LED off after the beat flash
  if (now >= beatFlashUntil) digitalWrite(PIN_LED, HIGH);

#if SERIAL_MODE == 2 || SERIAL_MODE == 3
  if (now - lastStatusMs >= (SERIAL_MODE == 2 ? 2000u : 10000u)) {
    float fps = framesCount * 1000.0f / (now - lastStatusMs);
    float pages = framesCount ? (float)pagesCount / framesCount : 0.0f;
    lastStatusMs = now;
    framesCount = pagesCount = 0;
    // In raw mode the status goes out as a "#" note every 10 s, so it doesn't disturb the data
    Serial.printf("%s IR %u, red %u | %.1f fps, %.1f pages/frame, frame max %lu ms | breathing step max %lu ms | loop max %lu ms | BLE %s, %lu msg/s | FIFO resets %lu%s\n",
                  SERIAL_MODE == 2 ? "  (raw" : "# status:",
                  lastIr, lastRed, fps, pages, (unsigned long)frameMsMax, (unsigned long)breathMsMax,
                  (unsigned long)(loopMaxUs / 1000), ble.connected() ? "connected" : "advertising",
                  (unsigned long)(ble.takeNotifyCount() * 1000 / (SERIAL_MODE == 2 ? 2000u : 10000u)),
                  (unsigned long)fifoResets, SERIAL_MODE == 2 ? ")" : "");
    loopMaxUs = 0;
  }
#endif
  uint32_t loopUs = micros() - loopStartUs;
  if (loopUs > loopMaxUs) loopMaxUs = loopUs;
}
