gbrobotic/PulseLab/(commit log)

2026-10-19 Phase 0-1: project setup, MAX30100 pull-up fix, raw PPG bring-up
    [readings_template.csv]
2026-10-19 Phase 2: heart rate detection, start-up and finger movement fixes
    [02_heart_rate.ino, filter_design.py, ppg_dsp.h]
2026-10-20 Phase 4: OLED screens at 25 fps, button, signal quality, sessions
2026-10-20 Phase 7: guided breathing session (before/slow/after, HR swing, tested on device)
2026-10-20 Phase 8: BLE heart rate + PulseLab service, web dashboard, SDNN in guided result
    [dashboard_guided2.csv, dashboard_test1.csv]
2026-10-22 Phase 10: zero PCB layout, case, assembly checks
    [button_cap.step, button_cap.stl, case_base.step, case_base.stl, case_lid.step, case_lid.stl, fit_test_plate.stl]
2026-10-22 Phase 11 tools (calibration + test split), Phase 9 skipped, README and roadmap for Phase 12
    [readings_template.csv, simulated_readings.csv]
2026-10-22 Case moved to future work (designed, not built for submission)
